siliconwitchery/s1-popout-board/(notices)

Notices in the files:
kicad-proj/s1-popout-board.sch:
https://creativecommons.org/licenses/by/4.0
Released under the Creative Commons
kicad-proj/s1-popout-board.kicad_pcb:
Licenced under: CERN OHL-P-v2
Copyright 2022 © Silicon Witchery
